Skyduino/Skyduino-Hardware/SkyDuino-Hardware.kicad_pcb

## KiCad design SkyDuino-Hardware.kicad_pcb (2024-08-17)

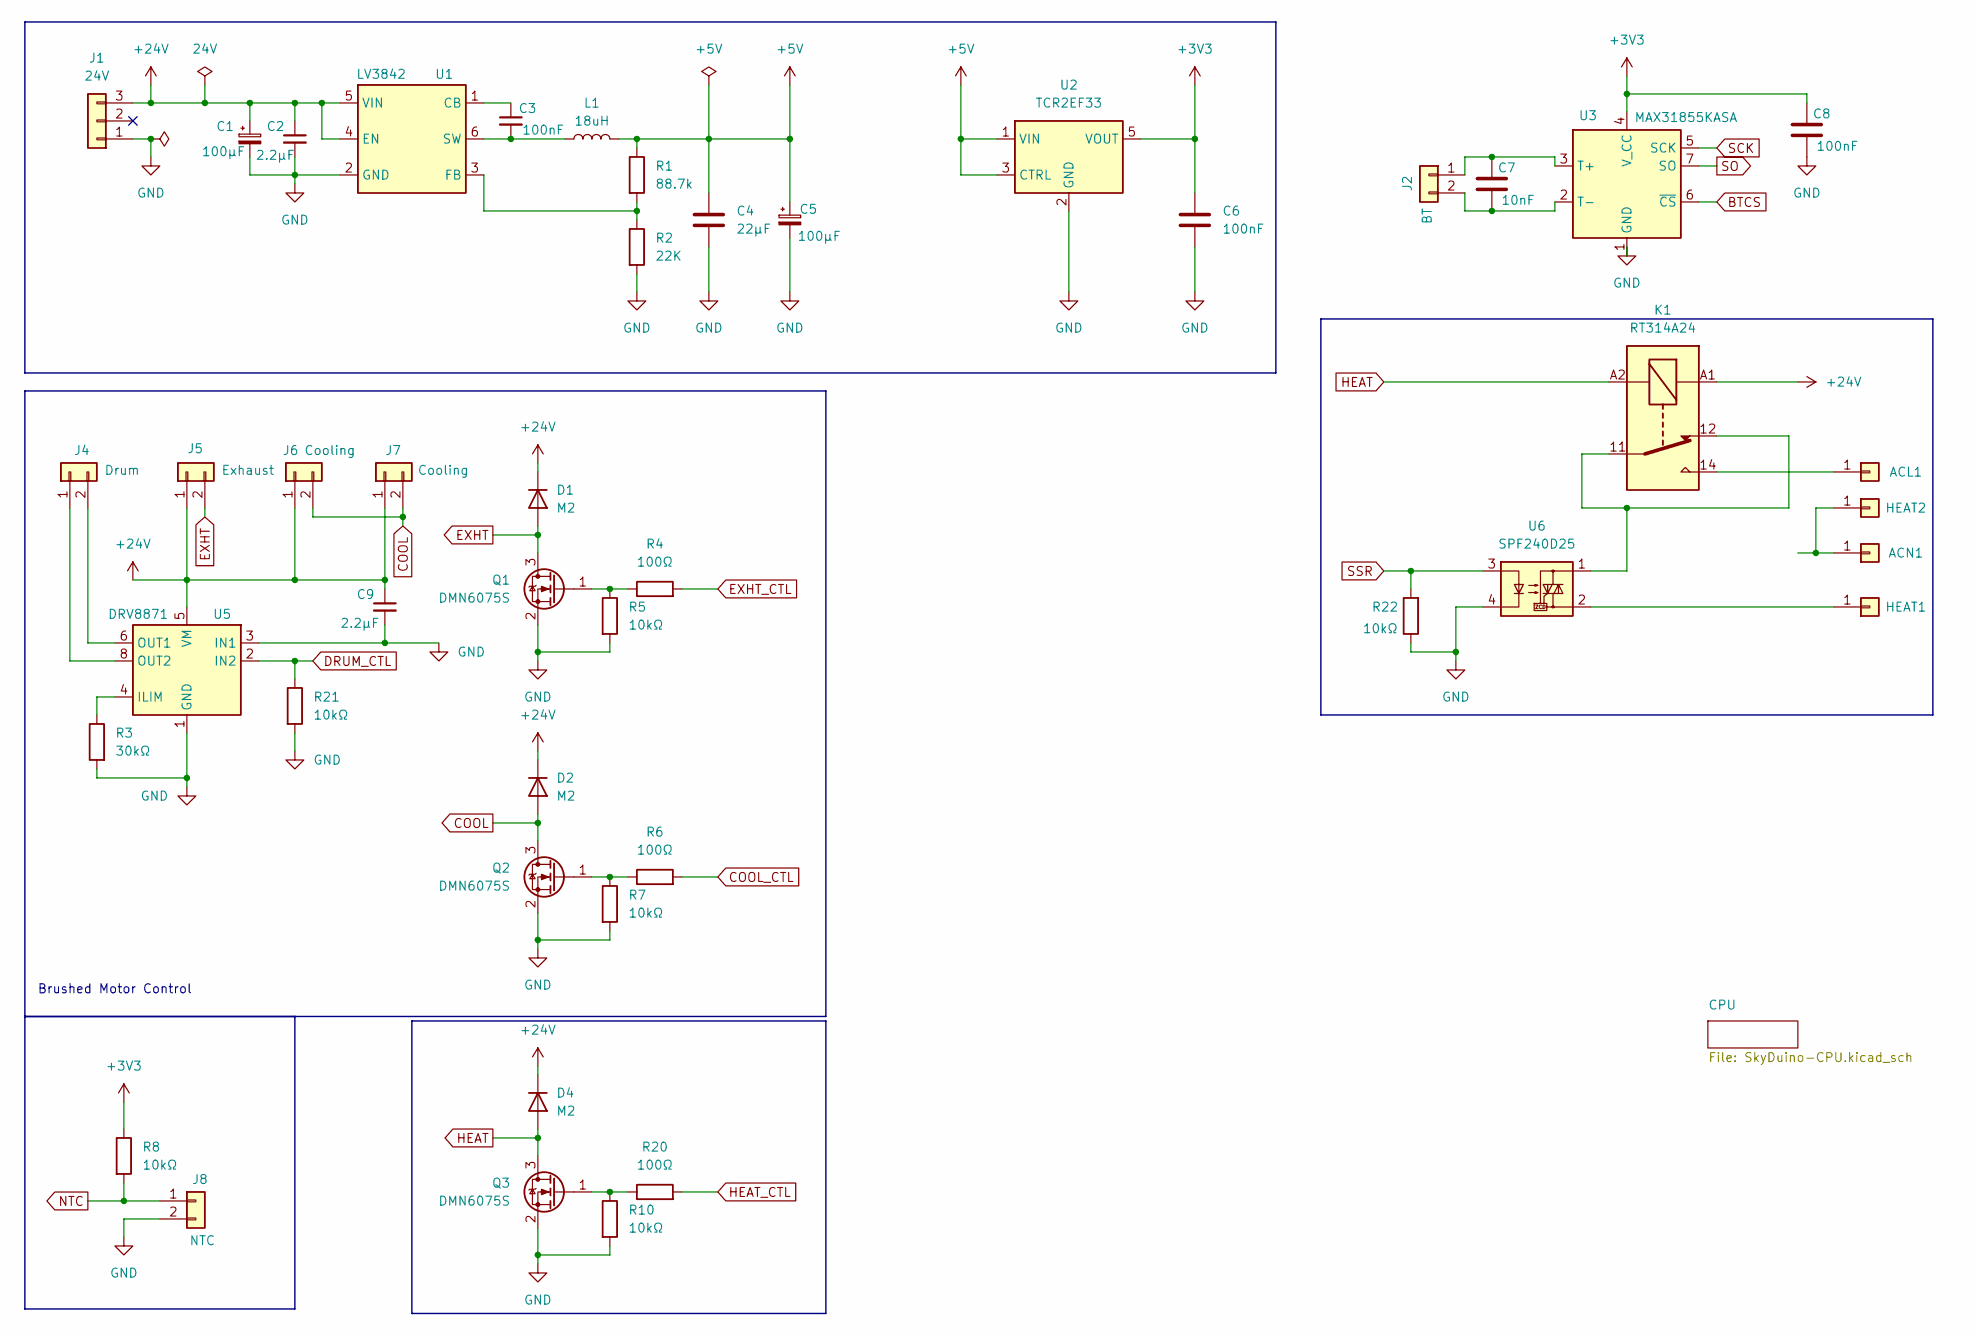
[picture p1: schematic SkyDuino-Hardware.kicad_sch, SkyDuino Roaster]

Parts:
ACL1: QC 19705-4303; QuickConnect_Tab_Molex_19705-4303; Mouser p/n 538-19705-4303
ACN1: QC 19705-4303; QuickConnect_Tab_Molex_19705-4303; Mouser p/n 538-19705-4303
C1, C5: 100µF; CP_Radial_D10.0mm_P5.00mm; Mouser p/n 667-ECA-2AM101
C2, C9: 2.2µF; C_0805_2012Metric_Pad1.18x1.45mm_HandSolder; Mouser p/n 187-CL21B225KPFNNNF; LCSC C377773
C3, C6, C8: 100nF; C_0805_2012Metric_Pad1.18x1.45mm_HandSolder; Mouser p/n 810-C2012X7R2A104K; LCSC C49678
C4: 22µF; C_0805_2012Metric_Pad1.18x1.45mm_HandSolder; Mouser p/n 810-C2012X5R1V226MAC; LCSC C45783
C7: 10nF; C_0805_2012Metric_Pad1.18x1.45mm_HandSolder; Mouser p/n 810-C2012C0G1H103J-1; LCSC C1710
D1, D2, D4: M2; D_SMA_Handsoldering; Mouser p/n 637-M2; LCSC C14996
HEAT1, HEAT2: QC 19705-4303; QuickConnect_Tab_Molex_19705-4303; Mouser p/n 538-19705-4303
J1: 24V; JST_XH_B3B-XH-A_1x03_P2.50mm_Vertical
J2: BT; KF7.62_2P
J4: Drum; JST_XH_B2B-XH-A_1x02_P2.50mm_Vertical
J5: Exhaust; JST_XH_B2B-XH-A_1x02_P2.50mm_Vertical
J6, J7: Cooling; JST_XH_B2B-XH-A_1x02_P2.50mm_Vertical
J8: NTC; JST_XH_B2B-XH-A_1x02_P2.50mm_Vertical
K1: RT314A24; Relay_SPDT_Schrack-RT1-16A-FormC_RM5mm; Mouser p/n 655-RT314024
L1: 18uH; L_Bourns_SRN3015BTA; Mouser p/n 652-SRN3015BTA-180M; LCSC C19947604
Q1, Q2, Q3: DMN6075S; SOT-23; Mouser p/n 621-DMN6075S-7; LCSC C155242
R1: 88.7k; R_0805_2012Metric_Pad1.20x1.40mm_HandSolder; Mouser p/n 667-ERA-6AEB8872V; LCSC C706252
R2: 22K; R_0805_2012Metric_Pad1.20x1.40mm_HandSolder; Mouser p/n 603-RT0805DRE0722KL; LCSC C17560
R3: 30kΩ; R_0805_2012Metric_Pad1.20x1.40mm_HandSolder; Mouser p/n 603-RC0805FR-0730KL; LCSC C17633
R4, R6, R20: 100Ω; R_0805_2012Metric_Pad1.20x1.40mm_HandSolder; Mouser p/n 603-AC0805FR-10100RL; LCSC C17408
R5, R7, R8, R10, R21, R22: 10kΩ; R_0805_2012Metric_Pad1.20x1.40mm_HandSolder; Mouser p/n 603-AC0805JR-0710KL; LCSC C17414
U1: LV3842; SOT-23-6; Mouser p/n 595-LV3842XFDBVR; LCSC C5219371
U2: TCR2EF33; SC-74A-5_1.55x2.9mm_P0.95mm; Mouser p/n 757-TCR2EF33LMCT; LCSC C843273
U3: MAX31855KASA; SOIC-8_3.9x4.9mm_P1.27mm; Mouser p/n 700-MAX31855KASA+T; LCSC C52028
U5: DRV8871; Texas_HTSOP-8-1EP_3.9x4.9mm_P1.27mm_EP2.95x4.9mm_Mask2.4x3.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; Mouser p/n 595-DRV8871DDA; LCSC C75864
U6: SPF240D25; SSR_Crydom_SPF240D25; Mouser p/n 558-SPF240D25

Connections:
+3V3: C6.1, C8.1, R8.1, U2.5 (VOUT), U3.4 (V_CC); also elsewhere on the board
+5V: C4.1, C5.1, L1.2, R1.1, U2.1 (VIN), U2.3 (CTRL); also elsewhere on the board
+24V: C1.1, C2.1, C9.1, D1.1 (K), D2.1 (K), D4.1 (K), J1.3, J5.1, J6.1, J7.1, K1.A1, U1.4 (EN), U1.5 (VIN), U5.5 (VM)
BTCS: U3.6 (~CS); also elsewhere on the board
COOL: D2.2 (A), J6.2, J7.2, Q2.3 (D)
COOL_CTL: R6.2; also elsewhere on the board
DRUM_CTL: R21.1, U5.2 (IN2); also elsewhere on the board
EXHT: D1.2 (A), J5.2, Q1.3 (D)
EXHT_CTL: R4.2; also elsewhere on the board
GND: C1.2, C2.2, C4.2, C5.2, C6.2, C8.2, C9.2, J1.1, J8.2, Q1.2 (S), Q2.2 (S), Q3.2 (S), R2.2, R3.2, R5.2, R7.2, R10.2, R21.2, R22.1, U1.2 (GND), U2.2 (GND), U3.1 (GND), U5.1 (GND), U5.3 (IN1), U5.7 (GND), U5.9 (GND), U6.4; also elsewhere on the board
HEAT: D4.2 (A), K1.A2, Q3.3 (D)
HEAT_CTL: R20.2; also elsewhere on the board
NTC: J8.1, R8.2; also elsewhere on the board
unnamed: ACL1.1, K1.14
unnamed: ACN1.1, HEAT2.1
unnamed: HEAT1.1, U6.2
unnamed: C7.1, J2.1, U3.3 (T+)
unnamed: C7.2, J2.2, U3.2 (T-)
unnamed: J4.1, U5.8 (OUT2)
unnamed: J4.2, U5.6 (OUT1)
unnamed: K1.11, K1.12, U6.1
unnamed: Q1.1 (G), R4.1, R5.1
unnamed: Q2.1 (G), R6.1, R7.1
unnamed: Q3.1 (G), R10.1, R20.1
unnamed: C3.1, U1.1 (CB)
unnamed: R1.2, R2.1, U1.3 (FB)
unnamed: C3.2, L1.1, U1.6 (SW)
unnamed: R3.1, U5.4 (ILIM)
SCK: U3.5 (SCK); also elsewhere on the board
SO: U3.7 (SO); also elsewhere on the board
SSR: R22.2, U6.3; also elsewhere on the board

Notes on the sheet:
Brushed Motor Control

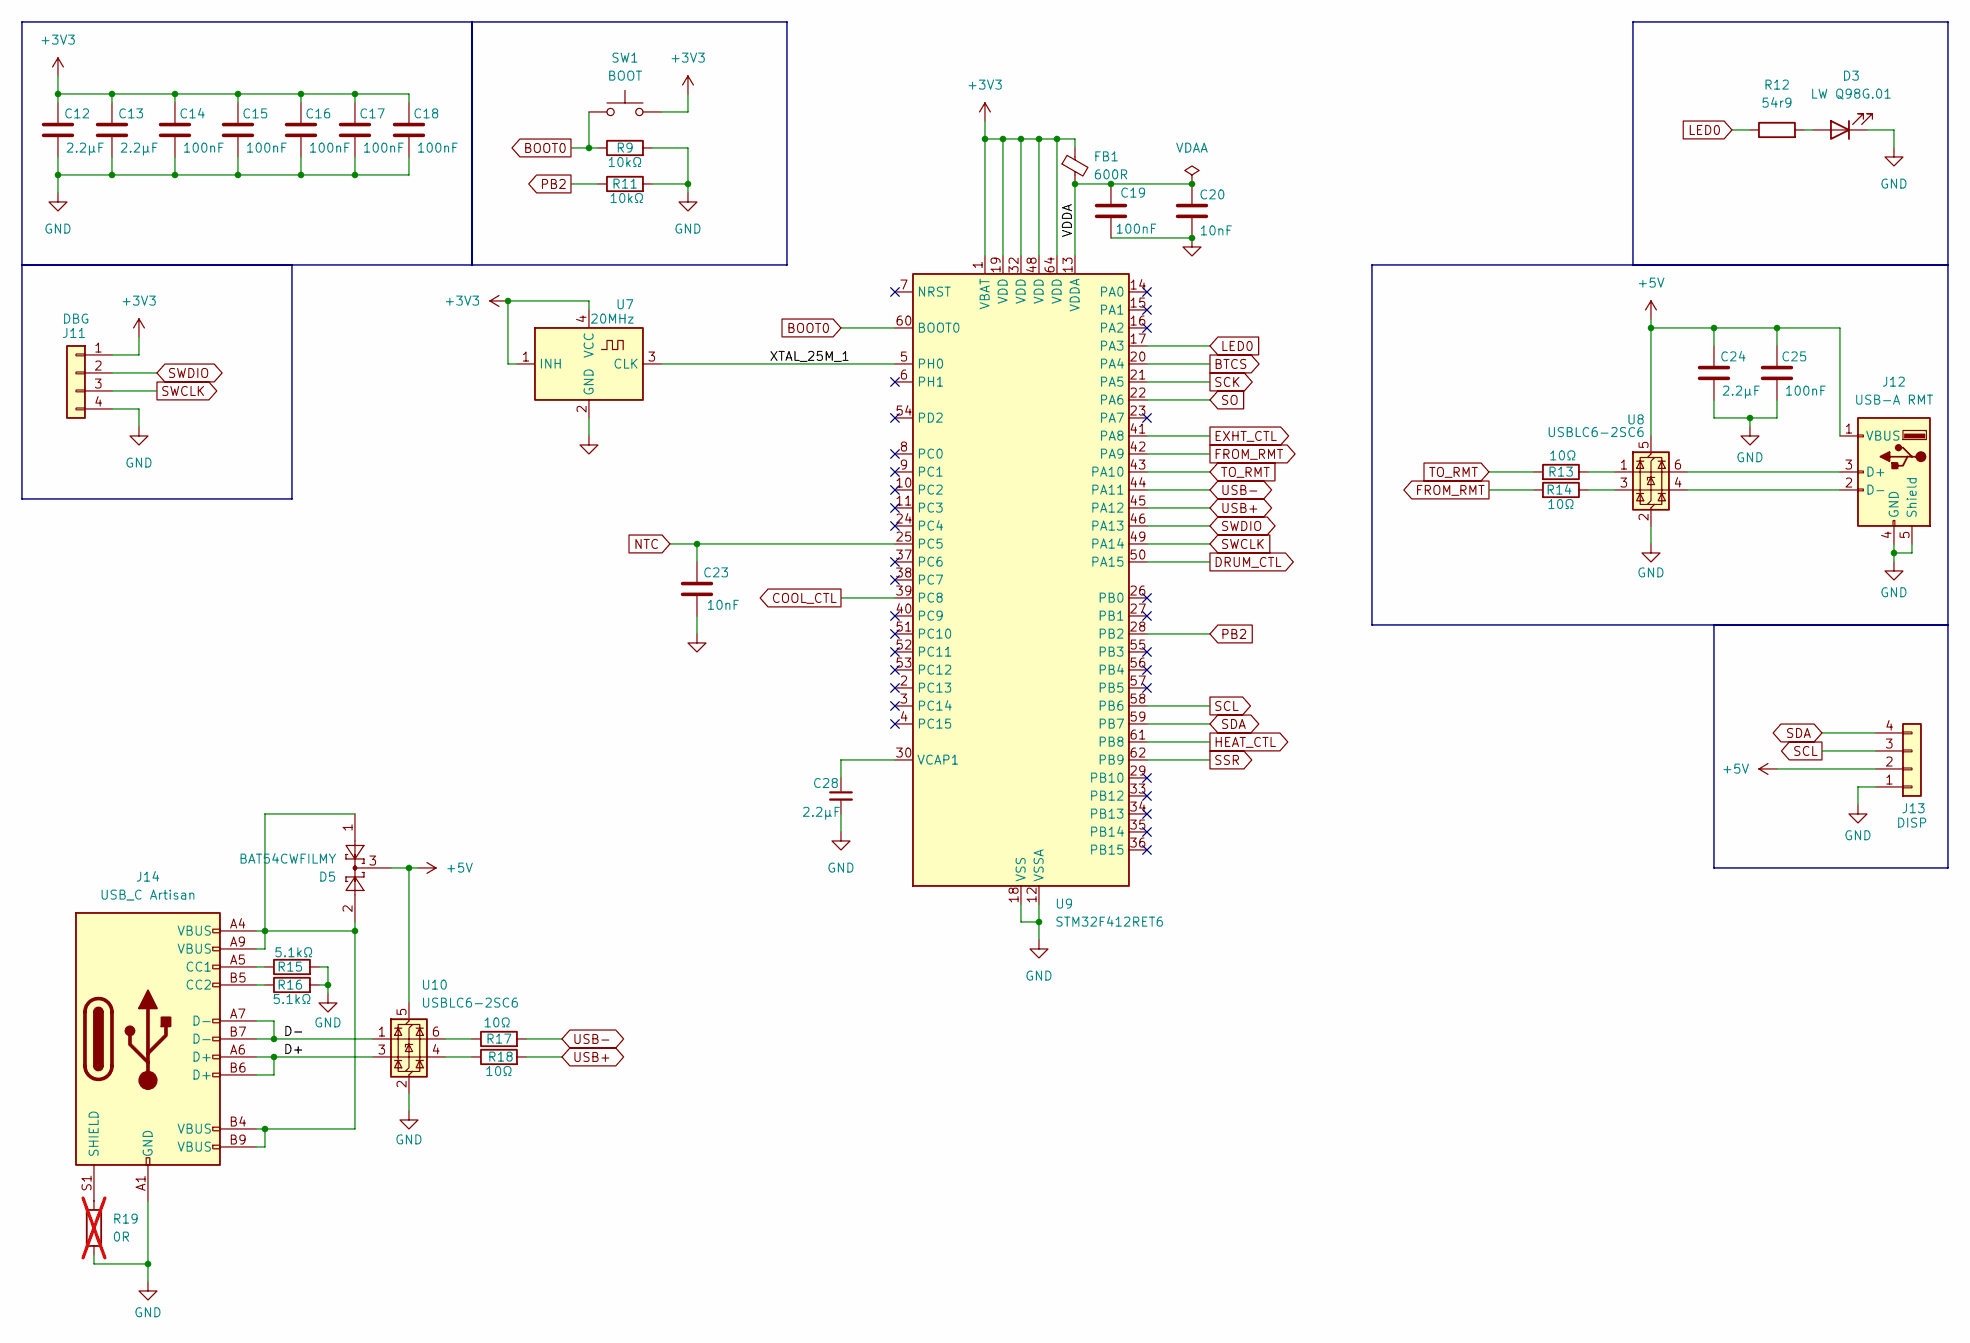
[picture p2: schematic SkyDuino-CPU.kicad_sch, SkyDuino Roaster]

Parts:
C12, C13, C24, C28: 2.2µF; C_0805_2012Metric_Pad1.18x1.45mm_HandSolder; Mouser p/n 187-CL21B225KPFNNNF; LCSC C377773
C14, C15, C16, C17, C18, C19, C25: 100nF; C_0805_2012Metric_Pad1.18x1.45mm_HandSolder; Mouser p/n 810-C2012X7R2A104K; LCSC C49678
C20, C23: 10nF; C_0805_2012Metric_Pad1.18x1.45mm_HandSolder; Mouser p/n 810-C2012C0G1H103J-1; LCSC C1710
D3: LW Q98G.01; LED_0805_2012Metric_Pad1.15x1.40mm_HandSolder; Mouser p/n 720-LWQ98G01R2T13K6L; LCSC C34499
D5: BAT54CWFILMY; SOT-323_SC-70; Mouser p/n 511-BAT54CWFILMY; LCSC C2980568
FB1: 600R; L_0805_2012Metric_Pad1.05x1.20mm_HandSolder; Mouser p/n 810-MMZ2012R601AT000; LCSC C1017
J11: DBG; PinHeader_1x04_P2.54mm_Vertical
J12: USB-A RMT; USB_A_Molex_67643_Horizontal_and_AmphenolFCI_87583; Mouser p/n 538-67643-0910
J13: DISP; PinHeader_1x04_P2.54mm_Vertical
J14: USB_C Artisan; USB_C_Receptacle_Molex_Upright; Mouser p/n 538-216989-0001
R9, R11: 10kΩ; R_0805_2012Metric_Pad1.20x1.40mm_HandSolder; Mouser p/n 603-AC0805JR-0710KL; LCSC C17414
R12: 54r9; R_0805_2012Metric_Pad1.20x1.40mm_HandSolder; Mouser p/n 667-ERJ-6ENF54R9V; LCSC C17408
R13, R14, R17, R18: 10Ω; R_0805_2012Metric_Pad1.20x1.40mm_HandSolder; Mouser p/n 603-RC0805FR-1010RL; LCSC C17415
R15, R16: 5.1kΩ; R_0805_2012Metric_Pad1.20x1.40mm_HandSolder; Mouser p/n 603-RC0805JR-135K1L; LCSC C27834
R19: 0R; R_0805_2012Metric_Pad1.20x1.40mm_HandSolder; not fitted
SW1: BOOT; SW_PUSH_6mm_H4.3mm
U7: 20MHz; Oscillator_SMD_Kyocera_KC2520Z-4Pin_2.5x2.0mm; Manufacturer p/n SX2M20.000B10F20TNN; LCSC C7431315
U8, U10: USBLC6-2SC6; SOT-23-6; Mouser p/n 511-USBLC6-2SC6; LCSC C7519
U9: STM32F412RET6; LQFP-64_10x10mm_P0.5mm; Mouser p/n 511-STM32F412RET6; LCSC STM32F412RET6

Connections:
+3V3: C12.1, C13.1, C14.1, C15.1, C16.1, C17.1, C18.1, FB1.1, J11.1, SW1.2, U7.1 (INH), U7.4 (VCC), U9.1 (VBAT), U9.19 (VDD), U9.32 (VDD), U9.48 (VDD), U9.64 (VDD); also elsewhere on the board
+5V: C24.1, C25.1, D5.3, J12.1 (VBUS), J13.2, U8.5 (VBUS), U10.5 (VBUS); also elsewhere on the board
/CPU/D+: J14.A6 (D+), J14.B6 (D+), U10.3 (I/O2)
/CPU/D-: J14.A7 (D-), J14.B7 (D-), U10.1 (I/O1)
/CPU/VDDA: C19.2, C20.2, FB1.2, U9.13 (VDDA)
/CPU/XTAL_25M_1: U7.3 (CLK), U9.5 (PH0)
BOOT0: R9.1, SW1.1, U9.60 (BOOT0)
BTCS: U9.20 (PA4); also elsewhere on the board
COOL_CTL: U9.39 (PC8); also elsewhere on the board
DRUM_CTL: U9.50 (PA15); also elsewhere on the board
EXHT_CTL: U9.41 (PA8); also elsewhere on the board
FROM_RMT: R14.2, U9.42 (PA9)
GND: C12.2, C13.2, C14.2, C15.2, C16.2, C17.2, C18.2, C19.1, C20.1, C23.2, C24.2, C25.2, C28.2, D3.1 (K), J11.4, J12.4 (GND), J12.5 (Shield), J13.1, J14.A1 (GND), J14.A12 (GND), J14.B1 (GND), J14.B12 (GND), R9.2, R11.2, R15.2, R16.2, R19.2, U7.2 (GND), U8.2 (GND), U9.12 (VSSA), U9.18 (VSS), U9.31 (VSS), U9.47 (VSS), U9.63 (VSS), U10.2 (GND); also elsewhere on the board
HEAT_CTL: U9.61 (PB8); also elsewhere on the board
LED0: R12.1, U9.17 (PA3)
NTC: C23.1, U9.25 (PC5); also elsewhere on the board
unnamed: D3.2 (A), R12.2
unnamed: D5.1, D5.2, J14.A4 (VBUS), J14.A9 (VBUS), J14.B4 (VBUS), J14.B9 (VBUS)
unnamed: J12.3 (D+), U8.6 (I/O1)
unnamed: J12.2 (D-), U8.4 (I/O2)
unnamed: J14.A5 (CC1), R15.1
unnamed: J14.B5 (CC2), R16.1
unnamed: J14.S1 (SHIELD), R19.1
unnamed: R13.1, U8.1 (I/O1)
unnamed: R14.1, U8.3 (I/O2)
unnamed: R17.1, U10.6 (I/O1)
unnamed: R18.1, U10.4 (I/O2)
unnamed: C28.1, U9.30 (VCAP1)
PB2: R11.1, U9.28 (PB2)
SCK: U9.21 (PA5); also elsewhere on the board
SCL: J13.3, U9.58 (PB6)
SDA: J13.4, U9.59 (PB7)
SO: U9.22 (PA6); also elsewhere on the board
SSR: U9.62 (PB9); also elsewhere on the board
SWCLK: J11.3, U9.49 (PA14)
SWDIO: J11.2, U9.46 (PA13)
TO_RMT: R13.2, U9.43 (PA10)
USB+: R18.2, U9.45 (PA12)
USB-: R17.2, U9.44 (PA11)

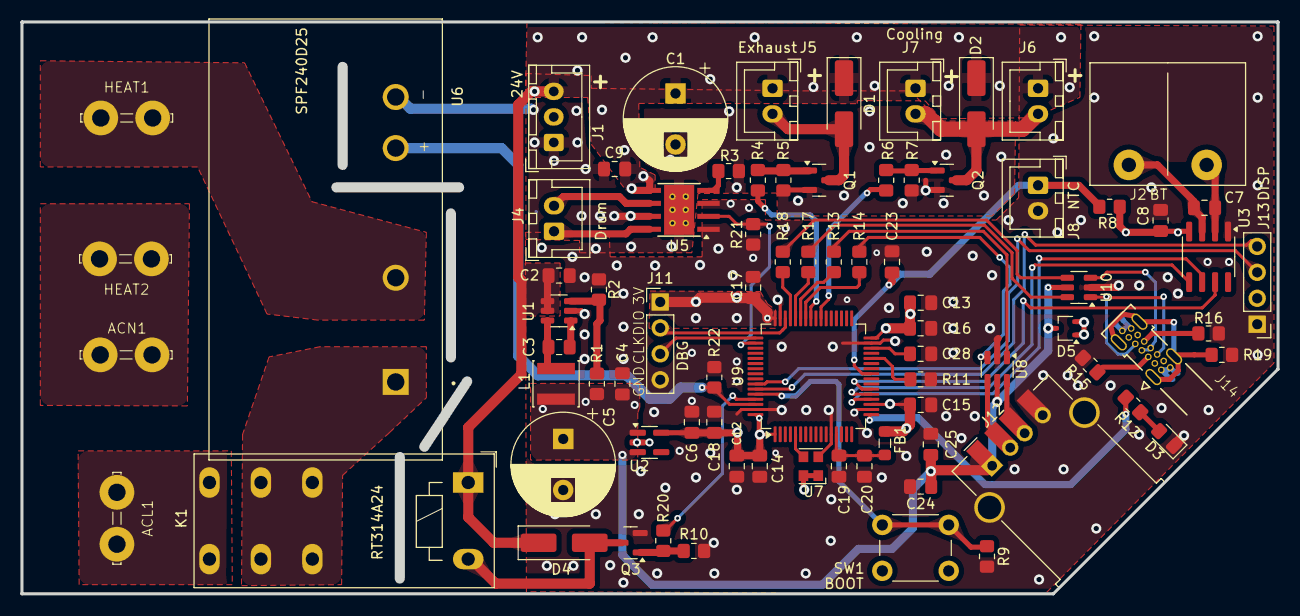
[picture p3: board SkyDuino-Hardware.kicad_pcb from above]

Board: 4 copper layers, 123.0 x 56.0 mm, 80 parts (0 on the bottom side), 58 nets.
