Skyduino/Skyduino-Hardware/(commit log)

2024-05-04 Add LDO and Motor Controls
    - Add 3v3 LDO
    - Add Motor controls
    [SkyDuino-Hardware.kicad_sch]
2024-05-04 Add Max33851 for BT
    [SkyDuino-Hardware.kicad_sch]
2024-05-04 Add KF 7.62mm footprint
2024-05-04 Move project footprints libraries into its own folder
2024-05-04 Add Exhaust Temp probe
    [SkyDuino-Hardware.kicad_sch]
2024-05-04 Add CPU sheet
    [SkyDuino-CPU.kicad_sch]
2024-05-04 WIP CPU
    [SkyDuino-CPU.kicad_sch]
2024-05-04 WIP CPU boot switches
    [SkyDuino-CPU.kicad_sch]
2024-05-04 Add Oscillators
    [SkyDuino-CPU.kicad_sch]
2024-05-04 Rough in on MCU control connections
    [SkyDuino-CPU.kicad_sch, SkyDuino-Hardware.kicad_sch]
2024-05-04 Add USB-C connector
    [SkyDuino-CPU.kicad_sch]
2024-05-04 Rename Connector_SH FPs lib
2024-05-04 Update KF7.64 footprint
2024-05-04 Add Footprint for USB-C receptacle
    [SkyDuino-CPU.kicad_sch]
2024-05-05 Update footprint for the boot button
    [SkyDuino-CPU.kicad_sch]
2024-05-06 Add USB-A for the remote
    [SkyDuino-CPU.kicad_sch]
2024-05-07 Add VBat to VDD
    [SkyDuino-CPU.kicad_sch]
2024-05-07 Add two extra 24v connectors
    [SkyDuino-Hardware.kicad_sch]
2024-05-07 Add NTC connection
    [SkyDuino-CPU.kicad_sch, SkyDuino-Hardware.kicad_sch]
2024-05-07 Add I2C for the display
    [SkyDuino-CPU.kicad_sch]
2024-05-07 Re-annotate. Add NTC capacitor
    [SkyDuino-CPU.kicad_sch, SkyDuino-Hardware.kicad_sch]
2024-05-07 Add SSR
    [SkyDuino-CPU.kicad_sch, SkyDuino-Hardware.kicad_sch]
2024-05-08 Add Quick Connect Tabs and footprints
    [SkyDuino-Hardware.kicad_sch]
2024-05-09 Update footprints
    [SkyDuino-CPU.kicad_sch, SkyDuino-Hardware.kicad_sch]
2024-05-09 Use ferrite bead for AVDD
    [SkyDuino-CPU.kicad_sch]
2024-05-09 Optimize pinouts
    [SkyDuino-CPU.kicad_sch, SkyDuino-Hardware.kicad_sch]
2024-05-09 Update PCB constraints
2024-05-09 Remove ET TC
    [SkyDuino-Hardware.kicad_sch]
2024-05-09 Optimize pinouts, update 2.2uF caps
    [SkyDuino-CPU.kicad_sch, SkyDuino-Hardware.kicad_sch]
2024-05-09 PCB WIP
    [SkyDuino-Hardware.kicad_pcb]
2024-05-10 Mark unconnected STM32 pins
    [SkyDuino-CPU.kicad_sch]
2024-05-11 Add 3d Models
    [SkyDuino-Hardware.kicad_pcb]
2024-05-11 Rearrange components. Fix 25MHz oscillator connection
    [SkyDuino-CPU.kicad_sch, SkyDuino-Hardware.kicad_pcb, SkyDuino-Hardware.kicad_sch]
2024-05-12 Update USB-C footprint
2024-05-12 WIP PCB tracing
    [SkyDuino-Hardware.kicad_pcb]
2024-05-12 Remove 25MHz load cap
    [SkyDuino-CPU.kicad_sch]
2024-05-12 Optimize SSR pin
    [SkyDuino-CPU.kicad_sch]
2024-05-12 Optimize LED pin
    [SkyDuino-CPU.kicad_sch]
2024-05-12 PCB Signalling routing
    [SkyDuino-Hardware.kicad_pcb]
2024-05-12 Copper fill for power
    [SkyDuino-Hardware.kicad_pcb]
2024-05-12 Label AC lines
    [SkyDuino-Hardware.kicad_pcb, SkyDuino-Hardware.kicad_sch]
2024-05-12 Pour AC lines
    [SkyDuino-Hardware.kicad_pcb]
2024-05-12 Fix DRC vialations
    [SkyDuino-Hardware.kicad_pcb]
2024-05-13 Unhide USB-C rec VBUS pins
    [SkyDuino-CPU.kicad_sch]
2024-05-13 Update USB-A 3d model
    [SkyDuino-Hardware.kicad_pcb]
2024-05-13 update footprint for resistors to hand solder
    [SkyDuino-CPU.kicad_sch, SkyDuino-Hardware.kicad_pcb, SkyDuino-Hardware.kicad_sch]
2024-05-13 Update sheet settings. Add revision text to pcb
    [SkyDuino-CPU.kicad_sch, SkyDuino-Hardware.kicad_pcb, SkyDuino-Hardware.kicad_sch]
2024-05-13 Update 5v pour
    [SkyDuino-Hardware.kicad_pcb]
2024-05-13 Use same 100nF cap everywhere
    [SkyDuino-Hardware.kicad_sch]
2024-05-14 Bump up revision 0.2
    [SkyDuino-CPU.kicad_sch, SkyDuino-Hardware.kicad_pcb, SkyDuino-Hardware.kicad_sch]
2024-05-14 Refactor power rail and optimize pours
    [SkyDuino-Hardware.kicad_pcb]
2024-05-14 Move SSR GND connection to B layer
    [SkyDuino-Hardware.kicad_pcb]
2024-05-14 Add silkscreen for DBG/DISP
    [SkyDuino-Hardware.kicad_pcb]
2024-05-16 Add Heat Safety relay
    [SkyDuino-CPU.kicad_sch, SkyDuino-Hardware.kicad_pcb, SkyDuino-Hardware.kicad_sch]
2024-05-16 WIP DRC
    [SkyDuino-Hardware.kicad_pcb, SkyDuino-Hardware.kicad_sch]
2024-05-17 Use VBus for 3V3 LDO
    [SkyDuino-CPU.kicad_sch, SkyDuino-Hardware.kicad_pcb, SkyDuino-Hardware.kicad_sch]
2024-05-17 Should have saved before commiting
    [SkyDuino-CPU.kicad_sch, SkyDuino-Hardware.kicad_sch]
2024-05-22 It is supposed to be STM32F41*2*RET6 MCU
    [SkyDuino-CPU.kicad_sch]
2024-05-29 Move values to User.1 layer
    [SkyDuino-Hardware.kicad_pcb]
2024-05-29 Refactor VBus/5v feeding
    [SkyDuino-CPU.kicad_sch, SkyDuino-Hardware.kicad_sch]
2024-05-30 Update PCB with VBus/5v changes
    [SkyDuino-Hardware.kicad_pcb]
2024-05-30 Add pull down resistors for SSR and Drum control
    [SkyDuino-Hardware.kicad_pcb, SkyDuino-Hardware.kicad_sch]
2024-05-30 Bump up revision. Use text variables for version control
    [SkyDuino-CPU.kicad_sch, SkyDuino-Hardware.kicad_pcb, SkyDuino-Hardware.kicad_sch]
2024-05-31 Fix cutouts, make those 1mm width
    [SkyDuino-Hardware.kicad_pcb]
2024-05-31 Update symbol fields
    [SkyDuino-CPU.kicad_sch, SkyDuino-Hardware.kicad_sch]
2024-05-31 Add kibot file
    [Skyduino-Hardware.kibot.yaml]
2024-06-01 Fix ERC/DRC warnings
    [SkyDuino-CPU.kicad_sch, SkyDuino-Hardware.kicad_pcb, SkyDuino-Hardware.kicad_sch]
2024-06-01 Update kibot config
    [Skyduino-Hardware.kibot.yaml]
2024-06-01 Fix warning for the step down converter
    [SkyDuino-Hardware.kicad_sch]
2024-06-01 Ibom extra fields and printing fixes
    [Skyduino-Hardware.kibot.yaml]
2024-06-01 Add User.1 layer to PDF fab layers printout
    [Skyduino-Hardware.kibot.yaml]
2024-06-01 Filter DRC edge errors caused by cutouts
    [Skyduino-Hardware.kibot.yaml]
2024-06-01 Mostly copper pours optimizations
    [SkyDuino-Hardware.kicad_pcb]
2024-06-01 Update Kibot PDF output, include inner copper layers
    [Skyduino-Hardware.kibot.yaml]
2024-06-01 No blender rendering, because of the edge cutouts
    [Skyduino-Hardware.kibot.yaml]
2024-06-03 Fix Drill output
2024-06-03 Don't silk variant on PCB
    [SkyDuino-Hardware.kicad_pcb]
2024-06-03 Change rev to dev tag. Don't print variant
    [SkyDuino-Hardware.kicad_pcb, Skyduino-Hardware.kibot.yaml]
2024-06-04 Update connector descriptions
    [SkyDuino-CPU.kicad_sch, SkyDuino-Hardware.kicad_sch]
2024-06-05 Add GIT Tag when available
    [SkyDuino-CPU.kicad_sch, SkyDuino-Hardware.kicad_pcb, SkyDuino-Hardware.kicad_sch, Skyduino-Hardware.kibot.yaml]
2024-06-05 Release Candidation version 0.4
    [SkyDuino-Hardware.kicad_pcb]
2024-06-05 Bump up revision 0.5.dev
    [SkyDuino-Hardware.kicad_pcb]
2024-06-10 JLCPCB and Revision tagging
    - Generate JLCPCB assembly files: BoM & Position
    - Tag revisions based on Git Tags
    [SkyDuino-CPU.kicad_sch, SkyDuino-Hardware.kicad_pcb, SkyDuino-Hardware.kicad_sch, Skyduino-Hardware.kibot.yaml]
2024-06-10 Add Config field and exclude TH components from assembly
    [SkyDuino-CPU.kicad_sch, SkyDuino-Hardware.kicad_pcb, SkyDuino-Hardware.kicad_sch]
2024-06-10 Update LCSC field
    [SkyDuino-CPU.kicad_sch, SkyDuino-Hardware.kicad_pcb, SkyDuino-Hardware.kicad_sch]
2024-06-10 Add JLC rotation offsets
    [SkyDuino-CPU.kicad_sch, SkyDuino-Hardware.kicad_sch]
2024-06-11 Add Alternative USB-C connector
    [SkyDuino-CPU.kicad_sch]
2024-06-11 Rotate U5 in correct direction
    [SkyDuino-Hardware.kicad_sch]
2024-06-11 Add Footprints and 3D models for the alternative USB-C connectors
2024-06-28 Make it fit the vented coffin enclosure.
    [SkyDuino-Hardware.kicad_pcb]
2024-06-28 Reposition SSR to fit into vented enclosure
    [SkyDuino-Hardware.kicad_pcb, SkyDuino-Hardware.kicad_sch]
2024-06-28 Move capacitor, 24v conn & TC conn
    [SkyDuino-Hardware.kicad_pcb]
2024-06-28 Reroute SSR control track
    [SkyDuino-Hardware.kicad_pcb]
2024-06-28 Fix DRC
    [SkyDuino-Hardware.kicad_pcb]
2024-06-28 Update PCB stackup to 1.2mm
    [SkyDuino-Hardware.kicad_pcb]
2024-07-05 Swap AC-Live and AC-Neutral on PCB (#9)
    Swap Live with Neutral on PCB, so the live is controlled by the Relay.
    [SkyDuino-Hardware.kicad_pcb, SkyDuino-Hardware.kicad_sch]
2024-08-16 Mirror i2c line labels on the back silk layer (#24)
    [SkyDuino-Hardware.kicad_pcb]
2024-08-17 Add a footprint for a combined Molex 67643 and Amphenol FCI 87583 USB A receptacle
2024-08-17 Add alternative part number for USB-A receptacle
    Use Amphenol FCI 87583 USB-A receptacle as an alternative part and
    update footprint to use the combined footprint of both connectors
    [SkyDuino-CPU.kicad_sch]
2024-08-17 Use a combined Molex/Amphenol USB-A footprint
    [SkyDuino-Hardware.kicad_pcb]
2024-08-17 Move Revision/Board silk printing so it is not clipped by the cutouts (#28)
    [SkyDuino-Hardware.kicad_pcb]
